tec499-20142/t01-core-musa/README.md

Projeto Core-MUSA
======
O projeto MUSA consiste no desenvolvimento da unidade de processamento do Processador MUSA.

Entendendo os Diretórios
-------------------------
  - doc    	: Contém todos os artefatos de documentação do sistema
  - rtl   	: Contém todos os módulos RTL sintetizáveis
  - fpga   	: Contém arquivos de projeto, constrais e módulos relativos ao FPGA
  - sim    	: Contém os módulos de teste, logs de simulação e banco de dados de formas de onda
