tec499-20142/t01-core-musa/rtl/README.md

Diretório de Arquivos RTL
==================================
Este diretório destina-se ao armazenamento dos módulos RTL sintetizáveis do projeto MUSA.

Organização de Subdiretórios
----------------------------
Sugere-se a organização dos subdiretórios da seguinte forma.

- sim/IF (arquivos do estágio IF);
- sim/ID (arquivos do estágio ID);
- sim/EX (arquivos do estágio EX);
- sim/MEM_WB (arquivos dos estágios MEM e WB);
