tec499-20142/t01-core-musa/doc/requirements/pt_br_requirements_specification.tex

%
% Portuguese-BR vertion
% 
\documentclass{article}
		
\usepackage{ipprocess}
% Use longtable if you want big tables to split over multiple pages.
\usepackage{longtable}
\usepackage[utf8]{inputenc} 
% Babel package is used to translate keywors to a specific language. 
% The option "brazil" defines portuguese-brazil as default language.
% Babel is also useful for hiphenation.
\usepackage[brazil]{babel}
		
\sloppy
		
\graphicspath{{./pictures/}} % Pictures dir
\makeindex
\begin{document}
		
\DocumentTitle{Especificação de Requisitos}
\Project{MUSA}
\Organization{Fazemos Qualquer Negócio Inc.}
\Version{Compilação 3.0}
\capa
			
%%%%%%%%%%%%%%%%%%%%%%%%%%%%%%%%%%%%%%%%%%%%%%%%%%
%% Revision History
%%%%%%%%%%%%%%%%%%%%%%%%%%%%%%%%%%%%%%%%%%%%%%%%%%

\section*{\center Histórico de Revisões}
	\vspace*{1cm}
	\begin{table}[ht]
		\centering
		\begin{tabular}[pos]{|m{2cm} | m{7.2cm} | m{3.8cm}|} \hline \cellcolor[gray]{0.9}

\textbf{Data} & \cellcolor[gray]{0.9}\textbf{Descrição} & \cellcolor[gray]{0.9} \textbf{Autor(es)}\\ \hline

\small 26/09/2014 & \small Inicialização do documento & \small patrickecomp \\ \hline      

\small 26/09/2014 & \small Inclusão dos requisitos [FR1] à [FR8] & \small patrickecomp \\ \hline 

\small 28/09/2014 & \small Inclusão dos requisitos [FR20] à [FR24] & \small santana22 e gabri14el \\ \hline

\small 28/09/2014 & \small Concepção da introdução e inclusão dos requisitos [FR10] e [FR11] & \small manuellemacedo \\ \hline 

\small 29/09/2014 & \small Inclusão dos requisitos [FR17] à [FR20], Inclusão dos requisitos [NFR3] à [NFR8] & \small patrickecomp, mirelarios e tarles-w7 \\ \hline    

\small 29/09/2014 & \small Inclusão dos requisitos [FR21] e [FR22] & \small ardersonqdv, lucas \\ \hline   

\small 29/09/2014 & \small Inclusão do requisito [FR7] & \small patrickecomp \\ \hline 

\small 30/09/2014 & \small Refinamento da introdução,  revisão preliminar do documento e revisão da [FR16] & \small santana22 \\ \hline

\small 30/09/2014 & \small Revisão do requisito [FR13] & \small santana22 e gabri14el \\ \hline

\small 30/09/2014 & \small Adição do requisito [NFR1] & \small santana22 \\ \hline

\small 30/09/2014 & \small Revisão dos requisitos [FR21] e [FR22] & \small lasilva\\ \hline

\small 30/09/2014 & \small Adição dos requisitos [FR23] à [FR26], adição dos requisitos [NFR2], [NFR9], [NFR10]  & \small manuellemacedo \\ \hline

\small 05/10/2014 & \small Revisão dos requisitos [FR12] à [FR16] & \small santana22 e gabri14el \\ \hline

\small 06/10/2014 & \small Adição dos requisitos [FR12], [FR14] [FR2], [FR4] & \small manuellemacedo \\ \hline %operações com imediato

\small 06/10/2014 & \small Adição dos requisitos [FR26] e revisão dos requisitos [NFR3], [NFR4], [NFR5] e [NFR8].  & \small patrickecomp e mirelarios \\ \hline

\small 06/10/2014 & \small Adição dos requisitos [FR17] à [FR19] & \small manuellemacedo \\ \hline % flags

\small 09/10/2014 & \small Revisão final do documento & \small manuellemacedo \\ \hline

		\end{tabular}
	\end{table}
\newpage

\section*{\center Histórico de Revisões}
\vspace*{1cm}
\begin{table}[ht]
	\centering
	\begin{tabular}[pos]{|m{2cm} | m{7.2cm} | m{3.8cm}|} \hline \cellcolor[gray]{0.9}
		
		\textbf{Data} & \cellcolor[gray]{0.9}\textbf{Descrição} & \cellcolor[gray]{0.9} \textbf{Autor(es)}\\ \hline
		
		\small 08/10/2014 & \small Adicionado a dependência do documento de requisitos da Processing Unit & \small Anderson e Lucas \\ \hline 
		
		\small 08/10/2014 & \small Mudança dos requisitos [FR29], [FR30] de NFR para FR, revisão dos requisitos [FR28], [NFR3], [NFR4] e [NFR5] & \small patrickecomp e mirelarios \\ \hline
		
		\small 08/10/2014 & \small Ajustes da introdução e das dependências. Remoção do NFR sobre Interfaceamento. & \small santana22 \\ \hline
		
		\small 15/10/2014 & \small Ajustes das instruções de desvios e da capa do documento. Ajustes das dependências. & \small santana22 e gabri14el \\ \hline
		
		\small 16/10/2014 & \small Ajustes nos requisitos funcionais de instruções lógicas e aritméticas & \small manuellemacedo \\ \hline
        
		\small 16/10/2014 & \small Ajustes nos requisitos funcionais de instruções de memória e ajuste nos requisitos não funcionais [NFR4] e [NFR2]. & \small patrickecomp \\ \hline
		
		\small 16/10/2014 & \small Ajustes dos requisitos [FR07], [FR16] e dos requisitos [FR26] e [FR27]. Alteração da introdução do documento e da seção 2: Requisitos funcionais. & \small lasilva \\ \hline 
		
  \end{tabular}
\end{table}
		
% TOC instantiation
\tableofcontents
\newpage
		
%%%%%%%%%%%%%%%%%%%%%%%%%%%%%%%%%%%%%%%%%%%%%%%%%%
%% Document main content
%%%%%%%%%%%%%%%%%%%%%%%%%%%%%%%%%%%%%%%%%%%%%%%%%%
\input{introducao}    
		
	\subsection{Visão Geral do Documento}
		\begin{itemize}
			\item \textbf{Requisitos funcionais -} lista de todos os requisitos funcionais.
			\item \textbf{Requisitos não funcionais -} lista de todos os requisitos não funcionais.
			\item \textbf{Dependências -} conjunto de dependências de IP-cores previstos.
		% 	\item \textbf{Notas -} apresenta a lista de notas apresentadas ao longo do documento.
		% 	\item \textbf{Referências -} lista de todos os textos referenciados nesse documento.
		\end{itemize}
		
	\subsection{Definições} 
		\begin{table}[H]
			\begin{center}
				\begin{tabular}[pos]{|m{2.5cm} | m{11.5cm}|} 
				\hline
				\cellcolor[gray]{0.9}\textbf{Termo} & \cellcolor[gray]{0.9}\textbf{Descrição} \\ \hline
				\flushright \centering {Requisito Funcional} & Requisitos de hardware que compõem os módulos, descrevendo as ações que o mesmo deve estar apto a executar. Estas informações são capturadas a partir do desenvolvimento dos casos de uso, que documentam as entradas, os processos e as saídas geradas.  \\ \hline
				\flushright \centering {Requisito Não \mbox{Funcional}} & Requisitos de hardware que compõem os módulos, representando as características que o mesmo deve ter, ou restrições que o mesmo deve operar. Estas características referem-se a técnicas, algoritmos, tecnologias e especificidades do Sistema como um todo.  \\ \hline
				\flushright \centering {Dependências} & Requisitos de reuso de IP-cores, descrevendo as funções que cada um deve exercer. \\ \hline
				\end{tabular}
			\end{center}
		\end{table}  
		
	% inicio da tabela de acronimos e abreviacoes do documento
	\subsection{Acrônimos e Abreviações}
	\begin{table}[H]
		\begin{center}
			\begin{tabular}[pos]{|m{2cm} | m{12cm}|} \hline
			\cellcolor[gray]{0.9}\textbf{Sigla} & \cellcolor[gray]{0.9}\textbf{Descrição} \\ \hline
		          FR      & Requisito Funcional  \\ \hline
		          NFR     & Requisito Não Funcional  \\ \hline
		          D       & Dependência  \\ \hline
				  PC      & Program Counter \\ \hline 
			\end{tabular}
		\end{center}
	\end{table}  
	% fim  
		
	% inicio da descriao de prioridades de requisitos
	\subsection{Prioridades dos Requisitos}

	\begin{table}[H]
		\begin{center}
			\begin{tabular}[pos]{|m{2cm} | m{12cm}|} \hline
			\cellcolor[gray]{0.9}\textbf{Prioridade} & \cellcolor[gray]{0.9}\textbf{Característica} \\ \hline
			Importante      & Requisito sem o qual o sistema funciona, porém não como deveria.  \\ \hline
			Essencial       & Requisito que deve ser implementado para que o sistema funcione.  \\ \hline
			Desejável       & Requisito que não compromete o funcionamento do sistema.  \\ \hline
			\end{tabular}
		\end{center}
	\end{table}  
	% fim
		
\section{Requisitos Funcionais}
		Nesta seção são descritos os requisitos das instruções que devem ser realizadas pelo IP-core MUSA. 
		Nas subseções 2.1 e 2.2 são descritos os requisitos funcionais das operações lógicas e aritméticas.
		Nas subseções 2.3, 2.4 e 2.5 são apresentados os requisitos para as instruções de desvio, memória e 
		controle respectivamente. 
	\input{requisitosaritmetica}
	\input{requisitoslogicos}
	\input{requisitosdesvio}
	\input{requisitosmemoria}
	\input{requisitoscontrole}
			  
\section{Requisitos não Funcionais}
Esta seção apresenta a lista de Requisitos não Funcionais do projeto.
		  
	\input{naofuncional}
		  
\section{Dependências}
	
	\input{dependencias}  
	
% Optional bibliography section
% To use bibliograpy, first provide the ipprocess.bib file on the root folder.
% \bibliographystyle{ieeetr}
% \bibliography{ipprocess}
		  
\end{document}
