tec499-20142/t01-core-musa/doc/requirements/introducao.tex

\section{Introdução}

 A \textbf{Fazemos Qualquer Negócio Inc.} foi contratada para o desenvolvimento do \textit{IP-Core} \textbf{MUSA}, que é um micro processador de
 propósito geral que será utilizado em escolas de países africanos com o intuito de impulsionar o desenvolvimento deste continente. As seções
 subsequentes apresentam os requisitos funcionais e não funcionais como parte da fase de \textbf{Concepção} do IP-process.
 Os requisitos listados foram definidos a partir das necessidades do cliente para produção do \textit{MUSA}.
