tec499-20142/t01-core-musa/doc/requirements/requisitosaritmetica.tex

\subsection{Conjunto de Instruções Aritméticas} 
  
    \begin{functional}
      \requirement{Instrução ADD}
      {O módulo deve ser capaz de realizar a operação de soma de dois valores de 32 bits.}
      {Essencial}
      
       \requirement{Instrução ADDI}
      {O módulo deve ser capaz de realizar a operação de soma de dois valores de 32 bits, sendo um destes valor imediato.}
      {Essencial}

      \requirement{Instrução SUB}
      {O módulo deve ser capaz de realizar a operação de subtração de dois valores de 32 bits.}
      {Essencial}
      
      \requirement{Instrução SUBI}
      {O módulo deve ser capaz de realizar a operação de subtração de dois valores de 32 bits, sendo um destes valor imediato.}
      {Essencial}

      \requirement{Instrução MUL}
      {O módulo deve ser capaz de realizar a operação de multiplicação de dois valores de 32 bits. }
      {Essencial}

      \requirement{Instrução DIV}
      {O módulo deve ser capaz de realizar a operação de divisão de dois valores de 32 bits.}
      {Essencial} 

      \requirement{Tamanho da palavra de saída}
      {O componente deve apresentar uma saída única de 32 bits para todas as operações aritméticas.}
      {Essencial}       

      \requirement{Detecção de overflow aritmético}
      {O módulo deve ser capaz de detectar \textit{overflow} aritmético.}
      {Essencial}
      
      \requirement{Detecção de underflow aritmético}
      {O módulo deve ser capaz de detectar \textit{underflow} aritmético.}
      {Essencial}
      
%      \requirement{Detecção de zero}
%      {O módulo deve ser capaz de detectar no resultado da operação o valor zero e habilitar uma \textit{flag}.}
%      {Importante}
      
    \end{functional}
