tec499-20142/t01-core-musa/doc/requirements/requisitosdesvio.tex

\subsection{Conjunto de Instruções de Desvio}
	    
	  \begin{functional}
		\requirement{Instrução JR}
		{O módulo deve ser capaz de realizar desvios para endereços armazenados no registrador de destino.}
		{Essencial} 
		 
		 \requirement{Instrução JPC}
		 {O módulo deve ser capaz de realizar desvios para endereços relativos ao PC.}
		 {Essencial}
		 
		 \requirement{Instrução BRFL}
		 {O módulo deve ser capaz de realizar desvios condicionais com base no registrador de \textit{flags}.}
		 {Essencial}
		 
		 \requirement{Instrução CALL}
		 {O módulo deve ser capaz de desviar a execução para uma sub-rotina.}
		 {Essencial}
		 
		 \requirement{Instrução RET}
		 {O módulo deve ser capaz de retornar de uma sub-rotina.}
		 {Essencial}
         
	  \end{functional}
