tec499-20142/t01-core-musa/doc/requirements/requisitoslogicos.tex

\subsection{Conjunto de Instruções Lógicas} 
  
    \begin{functional}
    
      \requirement{Instrução AND}
      {O módulo deve ser capaz de realizar a operação AND lógico de dois operandos de 32 bits.}
      {Essencial}
      
     \requirement{Instrução ANDI}
      {O módulo deve ser capaz de realizar a operação AND lógico de dois operandos de 32 bits, sendo um destes valor imediato.}
      {Essencial}

      \requirement{Instrução OR}
      {O módulo deve ser capaz de realizar a operação OR lógico de dois operandos de 32 bits.}
      {Essencial}  
      
      \requirement{Instrução ORI}
      {O módulo deve ser capaz de realizar a operação OR lógico de dois operandos de 32 bits, sendo um destes valor imediato.}
      {Essencial} 
      
      \requirement{Instrução NOT}
      {O módulo deve ser capaz de realizar a operação NOT lógico de um operando de 32 bits.}
      {Essencial}   
      
      \requirement{Instrução CMP}
      {O módulo deve ser capaz de comparar dois operandos de 32 bits e ativa \textit{flags}.}
      {Essencial}
      
%      \requirement{Ativação do flag \textit{above}}
%      {O módulo deve ser capaz de ativar o flag \textit{above} após uma comparação entre duas entradas.}
%      {Importante}
      
%      \requirement{Ativação do flag \textit{equals}}
%      {O módulo deve ser capaz de ativar o flag \textit{equals} após uma comparação entre duas entradas.}
%      {Importante}
      
%      \requirement{Ativação do flag \textit{error}}
%      {O módulo deve ser capaz de ativar o flag \textit{error} após um erro ser detectado.}
%      {Importante}
      
    \end{functional}
