tec499-20142/t01-core-musa/doc/requirements/requisitosmemoria.tex

\subsection{Conjunto de Instruções de acesso à Memória}

	  \begin{functional}
		\requirement{Operação LW}
		{O módulo deve ser capaz de realizar leitura de dados na memória de dados.}
		{Essencial}
		
		\requirement{Operação SW}
		{O módulo deve ser capaz de armazenar dados na memória de dados.}
		{Essencial}
		
		\requirement{Leitura da memória de instruções}
		{O módulo deve ser capaz de ler instruções na memória de instruções.}
		{Essencial}
                
        \requirement{Modo de endereçamento de dados}
        {O módulo deve possuir três modos de endereçamento: imediato, por registrador e base-deslocamento.}
        {Essencial}

		\requirement{Padrão de conversão de tamanho de palavra}
		{O módulo deve converter dados de 16 bits para 32 bits utilizando o padrão zero-extend ou o padrão sign-extend.}
		{Essencial}
		 
	 \end{functional}
