tec499-20142/t01-core-musa/doc/requirements/pt_br_requirements_specification2.tex

%
% Portuguese-BR vertion
% 
\documentclass{article}

\usepackage{ipprocess}
% Use longtable if you want big tables to split over multiple pages.
% \usepackage{longtable}
\usepackage[utf8]{inputenc} 
% Babel package is used to translate keywors to a specific language. 
% The option "brazil" defines portuguese-brazil as default language.
% Babel is also useful for hiphenation.
\usepackage[brazil]{babel}

\sloppy

\graphicspath{{./pictures/}} % Pictures dir
\makeindex
\begin{document}

\DocumentTitle{Especificação de Requisitos}
\Project{Processador de Propósito Geral Simples}
\Organization{Universidade Estadual de Feira de Santana}
\Version{Compilação 2.0}
\capa

\newpage
	
	%%%%%%%%%%%%%%%%%%%%%%%%%%%%%%%%%%%%%%%%%%%%%%%%%%
	%% Revision History
	%%%%%%%%%%%%%%%%%%%%%%%%%%%%%%%%%%%%%%%%%%%%%%%%%%
	\section*{\center Histórico de Revisões}
	  \vspace*{1cm}
	  \begin{table}[ht]
	    \centering
	    \begin{tabular}[pos]{|m{2cm} | m{7.2cm} | m{3.8cm}|} 
	      \hline
	      \cellcolor[gray]{0.9}
	      \textbf{Data} & \cellcolor[gray]{0.9}\textbf{Descrição} & \cellcolor[gray]{0.9}\textbf{Autor(es)}\\ \hline
	      \hline
	      \small 26/09/2014 & \small Inicialização do documento & \small patrickecomp \\ \hline      
	      \small 26/09/2014 & \small Inclusão dos requisitos [FR1] à [FR8] & \small patrickecomp \\ \hline 
	      \small 28/09/2014 & \small Inclusão dos requisitos [FR12] à [FR16] & \small santana22 e gabri14el \\ \hline
	      \small 28/09/2014 & \small Concepção da introdução e inclusão dos requisitos [FR10] e [FR11] & \small manuellemacedo \\ \hline 
	      \small 29/09/2014 & \small Inclusão dos requisitos [FR17] à [FR20], Inclusão dos requisitos [NFR3] à [NFR8] & \small patrickecomp, mirelarios e tarles-w7 \\ \hline    
	      \small 29/09/2014 & \small Inclusão dos requisitos [FR21] e [FR22] & \small ardersonqdv, lucas \\ \hline   
	      \small 29/09/2014 & \small Inclusão do requisito [FR7] & \small patrickecomp \\ \hline 
	      \small 30/09/2014 & \small Refinamento da introdução,  revisão preliminar do documento e revisão da [FR16] & \small santana22 \\ \hline
	      \small 30/09/2014 & \small Revisão do requisito [FR13] & \small santana22 e gabri14el \\ \hline
	      \small 30/09/2014 & \small Adição do requisito [NFR1] & \small santana22 \\ \hline
	      \small 30/09/2014 & \small Revisão dos requisitos [FR21] e [FR22] & \small lasilva\\ \hline
	      \small 30/09/2014 & \small Adição dos requisitos [FR23] à [FR26], adição dos requisitos [NFR2], [NFR9], [NFR10]  & \small manuellemacedo \\ \hline
	    \end{tabular}
	  \end{table}
	
	\newpage
	
	% TOC instantiation
	\tableofcontents
	\newpage
	
	%%%%%%%%%%%%%%%%%%%%%%%%%%%%%%%%%%%%%%%%%%%%%%%%%%
	%% Document main content
	%%%%%%%%%%%%%%%%%%%%%%%%%%%%%%%%%%%%%%%%%%%%%%%%%%
	\input{introducao}    
	
	\subsection{Visão Geral do Documento}
	  \begin{itemize}
	   \item \textbf{Requisitos funcionais -} lista de todos os requisitos funcionais.
	   \item \textbf{Requisitos não funcionais -} lista de todos os requisitos não funcionais.
	%   \item \textbf{Dependências -} conjunto de dependências de IP-cores previstos.
	   % \item \textbf{Notas -} apresenta a lista de notas apresentadas ao longo do documento.
	   % \item \textbf{Referências -} lista de todos os textos referenciados nesse documento.
	  \end{itemize}
	
	  \subsection{Definições}
	  
	  \FloatBarrier
	  \begin{table}[H]
	    \begin{center}
	      \begin{tabular}[pos]{|m{2.5cm} | m{11.5cm}|} 
	        \hline
	        \cellcolor[gray]{0.9}\textbf{Termo} & \cellcolor[gray]{0.9}\textbf{Descrição} \\ \hline
	        \flushright \centering {Requisito Funcional} & Requisitos de hardware que compõem os módulos, descrevendo as ações que o 
	                                    mesmo deve estar apto a executar. Estas informações são capturadas a partir 
	                                    do desenvolvimento dos casos de uso, que documentam as entradas, os processos 
	                                    e as saídas geradas.  \\ \hline
	        \flushright \centering {Requisito Não \mbox{Funcional}} & Requisitos de hardware que compõem os módulos, representando as características 
	                                    que o mesmo deve ter, ou restrições que o mesmo deve operar. Estas características
	                                    referem-se a técnicas, algoritmos, tecnologias e especificidades do Sistema como um todo.  \\ \hline
	%        \flushright \centering {Dependências}              & Requisitos de reuso de IP-cores, descrevendo as funções que cada um deve exercer. \\ \hline
	      \end{tabular}
	    \end{center}
	  \end{table}  
	
	  % inicio da tabela de acronimos e abreviacoes do documento
	  \subsection{Acrônimos e Abreviações}
	    \FloatBarrier
	    \begin{table}[H]
	      \begin{center}
	        \begin{tabular}[pos]{|m{2cm} | m{12cm}|} 
	          \hline
	          \cellcolor[gray]{0.9}\textbf{Sigla} & \cellcolor[gray]{0.9}\textbf{Descrição} \\ \hline
	          FR      & Requisito Funcional  \\ \hline
	          NFR     & Requisito Não Funcional  \\ \hline
	%          D       & Dependência  \\ \hline
			  PC      & Program Counter \\ \hline 
	        \end{tabular}
	      \end{center}
	    \end{table}  
	  % fim  
	
	  % inicio da descriao de prioridades de requisitos
	  \subsection{Prioridades dos Requisitos}
	    \FloatBarrier
	    \begin{table}[H]
	      \begin{center}
	        \begin{tabular}[pos]{|m{2cm} | m{12cm}|} 
	          \hline
	          \cellcolor[gray]{0.9}\textbf{Prioridade} & \cellcolor[gray]{0.9}\textbf{Característica} \\ \hline
	          Importante      & Requisito sem o qual o sistema funciona, porém não como deveria.  \\ \hline
	          Essencial       & Requisito que deve ser implementado para que o sistema funcione.  \\ \hline
	          Desejável       & Requisito que não compromete o funcionamento do sistema.  \\ \hline
	        \end{tabular}
	      \end{center}
	    \end{table}  
	  % fim
	
	\section{Requisitos Funcionais}
	
	\input{requisitosaritmetica}
	
	\input{requisitoslogicos}
	    
	\input{requisitosdesvio}
	      
	\input{requisitosmemoria}
	 
	\input{requisitoscontrole}
		  
	 \section{Requisitos não Funcionais}
	  Esta seção apresenta a lista de Requisitos não Funcionais do projeto.
	  
	  \begin{nonfunctional}
	  	
	  \requirement{Interfaceamento}
	  {Este módulo deve ser capaz de interfacear com um mecanismo de saída.}
	  {Desejável}
	  
	  \requirement{Tamanho da palavra de instrução}
	  {O tamanho da palavra de intrução será de 16 bits.}
	  {Importante}
	  
	   \requirement{Modo de Armazenamento}
        {O tratamento e o armazenamento na memória de dados será feito no formato big-endian.}
        {Importante}
        
        \requirement{Modo de endereçamento da memória de dados e instruções}
        {O módulo deve possuir dois modos de endereçamento: Imediato e Direto.}
        {Importante}
        
       \requirement{Tipo de memória de dados}
        {O módulo deve utilizar memória do tipo SSRAM.}
        {Imnportante}
        
       \requirement{Tamanho da memória de dados}
        {A memória de dados deve ser de 512 Kbyte.}
        {Essencial}
        
       \requirement{Tamanho da memória de instruções}
        {A memória de dados deve ser de 512 Kbyte.}
        {Essencial}
        
       \requirement{Tamanho do banco de registradores}
        {O banco de registradores possui 8 registradores cada um
com 8 bits.}
        {Essencial}
	  
		\requirement{Formato dos Números}
		{Na representação dos números inteiros para a soma e subtração será adotado números com sinal e o complemento a 2 para representação de valores negativos}
		{Importante}
		
		\requirement{Arquitetura multi-ciclo}
		{As instruções serão executadas em alguns ciclos de clock.}
		{Essencial}		
			  
	  \end{nonfunctional}
	  
	\end{document}
