tec499-20142/t01-core-musa/doc/usecases/pt_br_use_cases.tex

 %
% Portuguese-BR vertion
% 
\documentclass{article}

\usepackage{ipprocess}
% Use longtable if you want big tables to split over multiple pages.
% \usepackage{longtable}
\usepackage[utf8]{inputenc} 
\usepackage[brazil]{babel} % Uncomment for portuguese
\usepackage{pdflscape}
\usepackage{tikz}
\usepackage{tikz-uml}

\sloppy

\graphicspath{{./pictures/}} % Pictures dir
\makeindex
\begin{document}

\DocumentTitle{Documento de Casos de Uso}
\Project{MUSA}
\Organization{Fazemos Qualquer Negócio Inc.}
\Version{Compilação 2.0}

\capa
\newpage

%%%%%%%%%%%%%%%%%%%%%%%%%%%%%%%%%%%%%%%%%%%%%%%%%%
%% Revision History
%%%%%%%%%%%%%%%%%%%%%%%%%%%%%%%%%%%%%%%%%%%%%%%%%%
\section*{\center Histórico de Revisões}
  \vspace*{1cm}
  \begin{table}[ht]
    \centering
    \begin{tabular}[pos]{|m{2cm} | m{7.2cm} | m{3.8cm}|} 
      \hline
      \cellcolor[gray]{0.9}
      \textbf{Data} & \cellcolor[gray]{0.9}\textbf{Descrição} & \cellcolor[gray]{0.9}\textbf{Autor(s)}\\ \hline
      
      \small 03/10/2014 & \small Document conception & \small manuellemacedo \\ \hline      
	
      \small 07/10/2014 & \small Adição do caso de uso da unidade lógica e aritmética & \small manuellemacedo \\ \hline
      \small 09/10/2014 & \small Retirado alguns atores do documento. Modificado os Casos de uso da Unidade de Controle e da UL. Adicionado algumas definições de siglas do Diagrama de Caso de Uso. & \small Lucas e Anderson \\ \hline 
      \small 09/10/2014 & \small Formatação e ajuste do documento & \small santana22 \\ \hline
      \small 09/10/2014 & \small Adição do caso de uso [UC 005] & \small tarleswalker \\ \hline
      \small 09/10/2014 & \small Adição dos casos de usos [UC 002] e [UC 003] & \small manuellemacedo \\ \hline
       \small 09/10/2014 & \small Adição do caso de uso [UC 004] & \small weverson \\ \hline
       \small 16/10/2014 & \small Refatoração da capa,  & \small manuellemacedo \\ \hline
       \small 24/10/2014 & \small Edição do caso de uso unidade de controle  & \small mirelarios e patrickecomp \\ \hline
       \small 24/10/2014 & \small Ajustes de sintaxe  & \small manuellemacedo \\ \hline
       \small 29/10/2014 & \small Edição do caso de uso Extensor de Bits  & \small mirelarios e patrickecomp \\ \hline
       \small 14/12/2014 & \small Refatoração do documento & \small santana22 \\ \hline
		\small 18/12/2014 & \small Refatoração do 	documento & \small santana22 e tarleswalker\\ \hline       
    \end{tabular}
  \end{table}

\newpage

% TOC instantiation
\tableofcontents
\newpage

%%%%%%%%%%%%%%%%%%%%%%%%%%%%%%%%%%%%%%%%%%%%%%%%%%
%% Document main content
%%%%%%%%%%%%%%%%%%%%%%%%%%%%%%%%%%%%%%%%%%%%%%%%%%
\input{introducao}

\input{atores}

\section{Casos de Usos}

	\input{instructionadd-sub-mult-div}
	\input{instruction-logicas}
	\input{instruction-imediatas}
	\input{instruction-memoria}
	\input{instruction-jump}

	%\input{unidadecontrole}

	%\input{ula}
	
	%\input{memoria}
	
	%\input{banco_registradores}
	
	%\input{extensor}

% Optional bibliography section
% To use bibliograpy, first provide the ipprocess.bib file on the root folder.
% \bibliographystyle{ieeetr}
% \bibliography{ipprocess}

\end{document}
