tec499-20142/t01-core-musa/doc/architecture/class_diagrams/Diagrama_de_classe_Stage_3_Esbo_o_.png

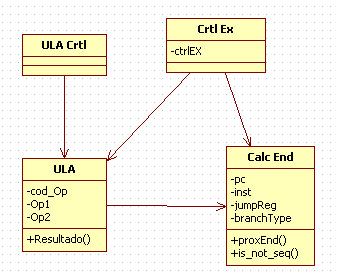
doc/architecture/class_diagrams/Diagrama_de_classe_Stage_3_Esbo_o_.png
