tec499-20142/t01-core-musa/doc/architecture/class_diagrams/estagioex.png

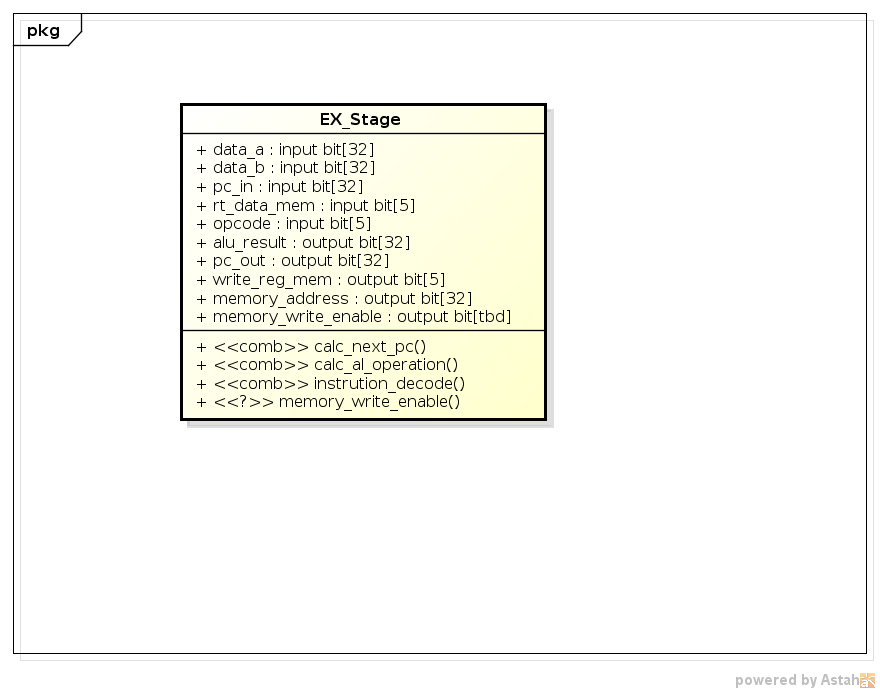
doc/architecture/class_diagrams/estagioex.png
