tec499-20142/t01-core-musa/doc/architecture/class_diagrams/por_est_gio.jpg

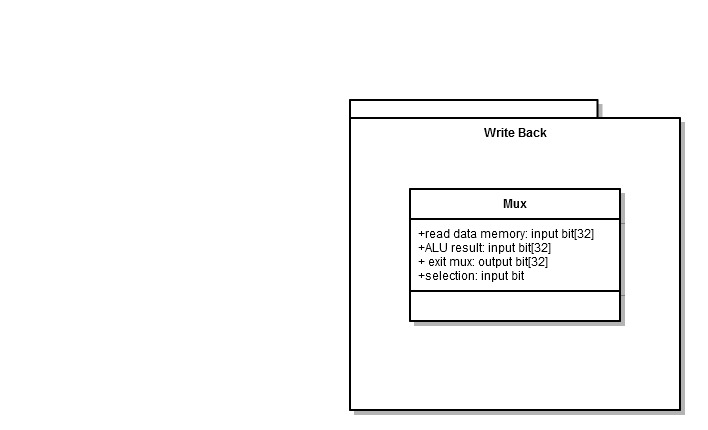
doc/architecture/class_diagrams/por_est_gio.jpg
