tec499-20142/t01-core-musa/doc/architecture/datapath/datapath_final.jpg

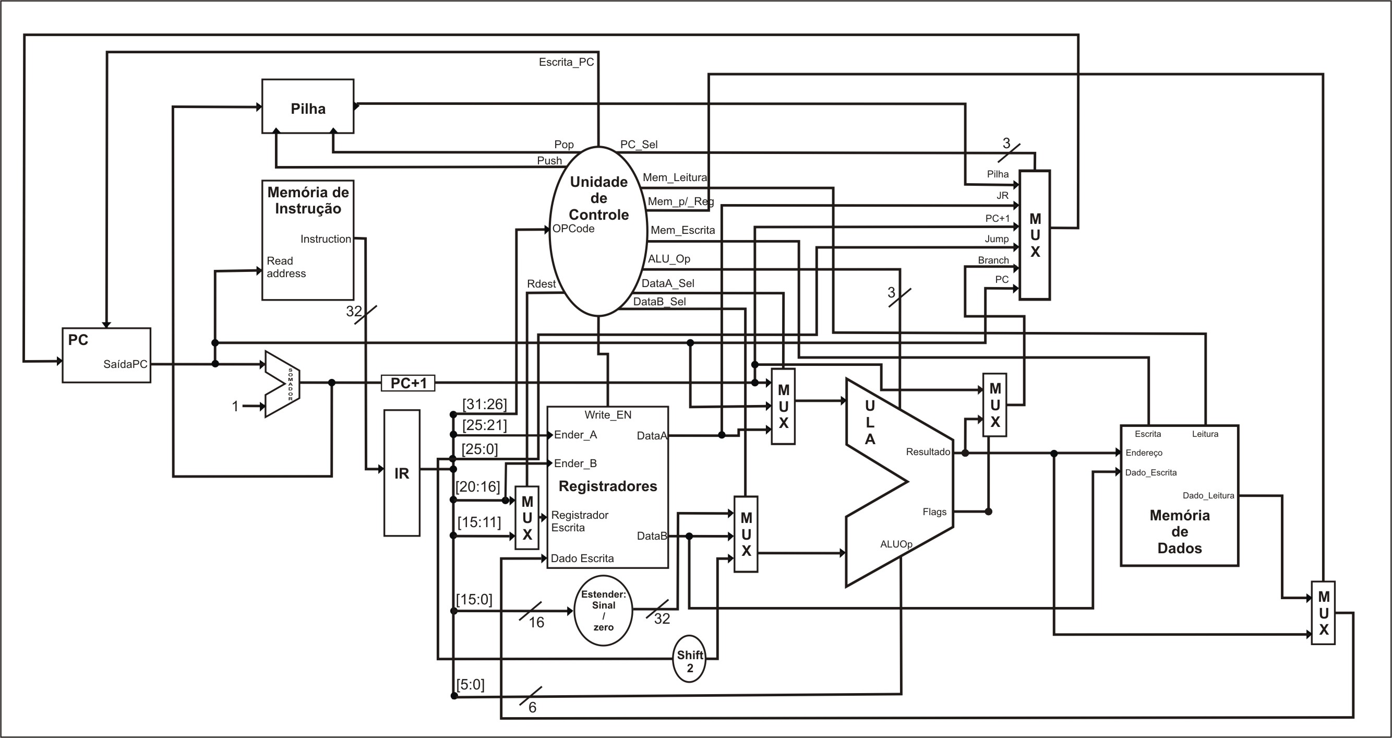
doc/architecture/datapath/datapath_final.jpg
