tec499-20142/t01-core-musa/doc/architecture/datapath/stage3.png

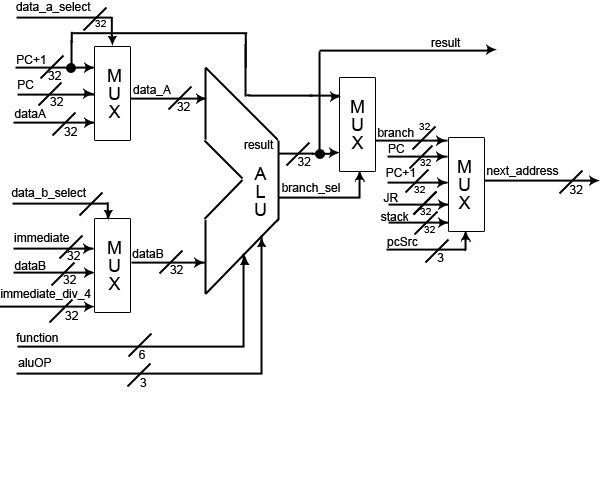
doc/architecture/datapath/stage3.png
