tec499-20142/t01-core-musa/doc/architecture/componentes.tex

\section{Descrição dos Componentes}
  A unidade de processamento a ser desenvolvida é composta a partir dos seguintes componentes:

  \begin{itemize}
    \item \textbf{Instruction Fetch --} Módulo responsavel pela busca da instrução na memória de instrução.
    \item \textbf{Instruction Decode e Register Read --} Módulo responsável pela decodificação das instruções e leitura do banco de registradores.
    \item \textbf{Execute Operation or Calculate Address --} Módulo responsável pela execução as operações de caractér lógico/aritmético ou cálculos endereços.
     \item \textbf{Memory Access e Write Back --} Módulo responsável pelo acesso a memória de dados e escrita no banco de registradores.
  \end{itemize}
