tec499-20142/t01-core-musa/(list of files, cad)

Other CAD files:
sim/ver/temp_ver/shift_two/verilog.psm
sim/ver/temp_ver/sign_extend/verilog.psm
sim/ver/temp_ver/sp_ram_with_init/verilog.psm
sim/ver/temp_ver/stage_@four_@five/verilog.psm
sim/ver/temp_ver/unit_control/verilog.psm
