tec499-20142/t01-core-musa/doc/usecases/usecases/instruction-jump.tikz.tex

\flushleft
  \begin{tikzpicture} 
    \begin{umlsystem}[x=0, fill=red!10]{Instruções de Desvio} 
      \umlusecase[x=-4,y=-3,name=buscar]{Buscar} 
      \umlusecase[x=0,y=-3, fill=green!20,width=1cm, name=enviar]{Enviar} 

	  \umlusecase[x=0,y=-5,name=decodificar]{Decodificar} 
      \umlusecase[x=-4,y=-5, fill=green!20,width=1cm, name=emitir]{Emitir}

	  \umlusecase[x=-4,y=-8,name=operar]{Operar/Calcular} 
      \umlusecase[x=0,y=-9, fill=green!20,width=1cm, name=mod_end]{Modificar Endereço}

      \umlactor[x=-8,y=-3]{IF} 
      \umlactor[x=4,y=-4]{ID}   
      \umlactor[x=-8,y=-6]{EX}

      \umlassoc{IF}{buscar}
      \umlassoc{enviar}{ID}
      \umlassoc{buscar}{enviar}
      
      \umlassoc{ID}{decodificar}
      \umlassoc{emitir}{EX}
      \umlassoc{decodificar}{emitir}

      \umlassoc{EX}{operar}
       \umlassoc{operar}{mod_end}
       \umlassoc{mod_end}{IF}
    \end{umlsystem} 
  \end{tikzpicture}
