tec499-20142/t01-core-musa/doc/architecture/step2.tex

\section{Decodificação da Instrução}
	\subsection{Diagrama de Classe}
  \begin{figure}[htpb!]
    \input{./classes/step2.tikz}
  \end{figure}
		
		\subsection{Definições de entrada e saída}
		
	\begin{center}
		\begin{longtable}[pos]{| l | c | c | m{7cm} |} \hline
			\multicolumn{1}{|c|}{\cellcolor[gray]{0.9}\textbf{Nome}} & 
			\multicolumn{1}{c|}{\cellcolor[gray]{0.9}\textbf{Tamanho}} & 
			\multicolumn{1}{c|}{\cellcolor[gray]{0.9}\textbf{Direção}} &
			\multicolumn{1}{c|}{\cellcolor[gray]{0.9}\textbf{Descrição}} \\ \hline
			\endhead
			\hline
			\endlastfoot
			
			clock & 1 & entrada & Clock do sistema \\ \hline
			reset & 1 & entrada & Sinal de reinício do estágio\\ \hline
			instruction & 32 & entrada & Instrução a ser executada. \\ \hline
			regDst & 1 & saída & Sinal que seleciona o endereço do registrador a ser escrito no banco registradores \\ \hline
			memRead & 1 & saída & Sinal de controle para realizar leitura da
			memória.
			\\ \hline
			memToReg & 1 & saída & Sinal de controle que define se o dado
			deve vir da ULA ou da memória
			\\ \hline
			aluOp & 3 & saída & Sinal que informa qual o tipo da operação que será realizada \\ \hline
			memWrite & 1 & saída & Sinal de controle para realizar escrita na
			memória. \\ \hline
			regWrite & 1 & saída & Sinal de controle para realizar escrita no
			registrador. \\ \hline
			data\_a\_select & 2 & saída &  Sinal para selecionar o conteúdo do primeiro operando \\ \hline
			data\_b\_select & 2 & saída & Sinal para selecionar o conteúdo do segundo operando operando \\ \hline
			pcSrc & 3 & saída & Sinal para selecionar o endereço da próxima instrução a ser executada \\ \hline
			pcWrite & 1 & saída & Sinal que habilita a modificação do valor de PC \\ \hline
			pop & 1 & saída & Sinal que habilita a leitura da Pilha de Instruções \\ \hline
			push & 1 & saída & Sinal que habilita a escrita na Pilha de Instruções \\ \hline
			writeData & 32 & entrada & Dado que será escrito no banco de registradores. \\ \hline
			writeRegister & 5 & entrada & Endereço do registrador a ser escrito no banco registradores \\ \hline
			function & 6 & saída & Variante especifica da operação \\\hline
			inst\_out & 32 & saída & Constante numérica  \\ \hline
			imdt\_div\_4 & 32 & saída & Contante numérica \\\hline
			opcode & 6 & entrada & Código da instrução a ser executada \\ \hline
			readRegister1 & 5 & entrada & Endereço do primeiro registrador \\ \hline
			readRegister2 & 5 & entrada & Endereço do segundo registrador\\ \hline 
			readData1 & 32 & saída & Conteúdo do primeiro registrador \\ \hline 
			readData2 & 32 & saída & Conteúdo do segundo registrador \\ \hline
		\end{longtable}
	\end{center}
    
    		\subsection{Tabela de microinstruções}

	\begin{center}
		\begin{longtable}[pos]{| c | c |} \hline
			\multicolumn{1}{|c|}{\cellcolor[gray]{0.9}\textbf{Código}} & 
			\multicolumn{1}{c|}{\cellcolor[gray]{0.9}\textbf{Instrução}} \\ \hline 
			\endhead
			\hline
			\endlastfoot
			
	    	1 & Lógicas, Aritméticas, MUL e DIV\\ \hline
            2 & ADDI \\ \hline
            3 & ANDI \\ \hline
            4 & SUBI \\ \hline
            5 & ORI \\ \hline
            6 & SW \\ \hline
            7 & LW \\ \hline
            8 & JR\\ \hline
            9 & JPC\\ \hline
            10 & BRFL\\ \hline
            11 & CALL\\ \hline
            12 & RET\\ \hline
            13 & HALT\\ \hline
            14 & NOP\\ \hline
            15 & CMP\\ \hline
		\end{longtable}
	\end{center}

	\begin{center}
		\begin{longtable}[pos]{| c | c | c | c | c | c | c | c | c | c | c | c | c | c | c | c | c |} \hline
			\multicolumn{1}{|c|}{\cellcolor[gray]{0.9}\textbf{\small Código}} & 
			\multicolumn{1}{c|}{\cellcolor[gray]{0.9}\textbf{1}} & 
			\multicolumn{1}{c|}{\cellcolor[gray]{0.9}\textbf{2}} &
			\multicolumn{1}{c|}{\cellcolor[gray]{0.9}\textbf{3}} &
            \multicolumn{1}{c|}{\cellcolor[gray]{0.9}\textbf{4}} &
            \multicolumn{1}{c|}{\cellcolor[gray]{0.9}\textbf{5}} &
            \multicolumn{1}{c|}{\cellcolor[gray]{0.9}\textbf{6}} &
            \multicolumn{1}{c|}{\cellcolor[gray]{0.9}\textbf{7}} &
            \multicolumn{1}{c|}{\cellcolor[gray]{0.9}\textbf{8}} &
            \multicolumn{1}{c|}{\cellcolor[gray]{0.9}\textbf{9}} &
            \multicolumn{1}{c|}{\cellcolor[gray]{0.9}\textbf{10}} &
			\multicolumn{1}{c|}{\cellcolor[gray]{0.9}\textbf{11}} &
			\multicolumn{1}{c|}{\cellcolor[gray]{0.9}\textbf{12}} &
            \multicolumn{1}{c|}{\cellcolor[gray]{0.9}\textbf{13}} &
            \multicolumn{1}{c|}{\cellcolor[gray]{0.9}\textbf{14}} &
            \multicolumn{1}{c|}{\cellcolor[gray]{0.9}\textbf{15}} \\ \hline
			\endhead
			\hline
			\endlastfoot
			
			\small regDst 			& 1   & 0   & 0   & 0   & 0   & 0   & 0   & 0   & 0   & 0   & 0   & 0   & 0  & 0 & 0 & 0\\ \hline
            \small memRead 			& 0   & 0   & 0   & 0   & 0   & 0   & 1   & 0   & 0   & 0   & 0   & 0   & 0  & 0 & 0 & 0\\ \hline
            \small memToReg 		& 0   & 0   & 0   & 0   & 0   & 0   & 1   & 0   & 0   & 0   & 0   & 0   & 0  & 0 & 0 & 0\\ \hline
            
            \small aluOp 			& \small 010 & \small 000 & \small 011 & \small 001 & \small 100 & \small 000 & \small 000 & \small 000 & \small 000 & \small 101 & \small 000 & \small 000 & \small 000 & \small 010 & \small 110 & \small 110\\ \hline
            
            \small memWrite 		& 0   & 0   & 0   & 0   & 0   & 1   & 0   & 0   & 0   & 0   & 0   & 0   & 0  & 0 & 0& 0\\ \hline
            \small regWrite 		& 1   & 1   & 1   & 1   & 1   & 0   & 1   & 0   & 0   & 0   & 0   & 0   & 0  & 0 & 0 & 0\\ \hline
            \small data\_a\_select	& 10  & 10  & 10  & 10  & 10  & 10  & 10  & 00  & 00  & 10  & 00  & 00  & 00 & 00 & 10 & 10\\ \hline
            \small data\_b\_select 	& 01  & 00  & 00  & 00  & 00  & 00  & 00  & 00  & 10  & 00  & 00  & 00  & 00 & 00 & 01 & 01\\ \hline
            
            \small pcSrc 			& \small 010 & \small 010   & \small 010 & \small 010 & \small 010 & \small 010 & \small 010 & \small 001 & \small 011 & \small 001 & \small 001 & \small 000 & \small 100 & \small 010 & \small 001& \small 001\\ \hline
            
            \small pop 				& 0   & 0   & 0   & 0   & 0   & 0   & 0   & 0   & 0   & 0   & 0   & 1   & 0  & 0 & 0 & 0\\ \hline
            \small push 			& 0   & 0   & 0   & 0   & 0   & 0   & 0   & 0   & 0   & 0   & 1   & 0   & 0  & 0 & 0 & 0\\ \hline

		\end{longtable}
	\end{center}
   
   \newpage
	
	\subsection{Datapath Interno}
	
	\begin{figure}[h!]
		\begin{center}
		
		\end{center}
	\end{figure}
