tec499-20142/t01-core-musa/doc/usecases/instruction-logicas.tex

\usecase{Instrução AND}

Este caso de uso especifica a ação da instrução AND. O objetivo é realizar uma a operação lógica AND entre dois valores.
 
\subsubsection*{Atores}
\textbf{IF, ID, EX, MEM/WB}

\preconditions 
\begin{itemize}
 \item O módulo \textbf{IF} precisa buscar uma instrução AND.
\end{itemize}

\postconditions
\begin{itemize}	
  \item Permitir execução da próxima instrução.
\end{itemize}

\subsubsection*{Fluxo Básico}
\begin{itemize}
\item O módulo \textbf{IF} busca a instrução AND a ser executada.
\item O módulo \textbf{ID} decodifica o tipo da instrução, emite sinais de controle para os demais módulos e disponibiliza os valores para o módulo \textbf{EX}.
\item O módulo \textbf{EX} realiza a operação lógica determinada dos valores e atualiza para a próxima instrução.
\item O módulo \textbf{MEM/WB} armazena o resultado da operação no módulo \textbf{ID}.
\end{itemize}

\usecase{Instrução OR}

Este caso de uso especifica a ação da instrução OR. O objetivo é realizar a operação lógica OR entre dois valores.
 
\subsubsection*{Atores}
\textbf{IF, ID, EX, MEM/WB}

\preconditions 
\begin{itemize}
 \item O módulo \textbf{IF} precisa buscar uma instrução OR.
\end{itemize}

\postconditions
\begin{itemize}	
  \item Permitir execução da próxima instrução.
\end{itemize}

\subsubsection*{Fluxo Básico}
\begin{itemize}
\item O módulo \textbf{IF} busca a instrução OR a ser executada.
\item O módulo \textbf{ID} decodifica o tipo da instrução, emite sinais de controle para os demais módulos e disponibiliza os valores para o módulo \textbf{EX}.
\item O módulo \textbf{EX} realiza a operação lógica determinada dos valores e atualiza para a próxima instrução.
\item O módulo \textbf{MEM/WB} armazena o resultado da operação no módulo \textbf{ID}.
\end{itemize}

\usecase{Instrução NOT}

Este caso de uso especifica a ação da instrução NOT. O objetivo é realizar a operação lógica NOT sobre um valor.
 
\subsubsection*{Atores}
\textbf{IF, ID, EX, MEM/WB}

\preconditions 
\begin{itemize}
 \item O módulo \textbf{IF} precisa buscar uma instrução NOT.
\end{itemize}

\postconditions
\begin{itemize}	
  \item Permitir execução de futuras instruções.
\end{itemize}

\subsubsection*{Fluxo Básico}
\begin{itemize}
\item O módulo \textbf{IF} busca a instrução NOT a ser executada.
\item O módulo \textbf{ID} decodifica o tipo da instrução, emite sinais de controle para os demais módulos e disponibiliza o valor para o módulo \textbf{EX}.
\item O módulo \textbf{EX} realiza a operação lógica determinada de negação do valor e atualiza para a próxima instrução.
\item O módulo \textbf{MEM/WB} armazena o resultado da operação no módulo \textbf{ID}.
\end{itemize}

\usecase{Instrução ANDI}

Este caso de uso especifica a ação da instrução ANDI. O objetivo é realizar uma a operação lógica AND entre dois valores sendo um destes imediato.

\subsubsection*{Atores}
\textbf{IF, ID, EX, MEM/WB}

\preconditions 
\begin{itemize}
	\item O módulo \textbf{IF} precisa buscar uma instrução ANDI.
\end{itemize}

\postconditions
\begin{itemize}	
	\item Permitir execução da próxima instrução.
\end{itemize}

\subsubsection*{Fluxo Básico}
\begin{itemize}
	\item O módulo \textbf{IF} busca a instrução ANDI a ser executada.
	\item O módulo \textbf{ID} decodifica o tipo da instrução, emite sinais de controle para os demais módulos e disponibiliza os valores para o módulo \textbf{EX}.
	\item O módulo \textbf{EX} realiza a operação lógica determinada dos valores e atualiza para a próxima instrução.
	\item O módulo \textbf{MEM/WB} armazena o resultado da operação no módulo \textbf{ID}.
\end{itemize}

\usecase{Instrução ORI}

Este caso de uso especifica a ação da instrução ORI. O objetivo é realizar a operação lógica OR entre dois valores sendo um destes imediato.

\subsubsection*{Atores}
\textbf{IF, ID, EX, MEM/WB}

\preconditions 
\begin{itemize}
	\item O módulo \textbf{IF} precisa buscar uma instrução ORI.
\end{itemize}

\postconditions
\begin{itemize}	
	\item Permitir execução da próxima instrução.
\end{itemize}

\subsubsection*{Fluxo Básico}
\begin{itemize}
	\item O módulo \textbf{IF} busca a instrução ORI a ser executada.
	\item O módulo \textbf{ID} decodifica o tipo da instrução, emite sinais de controle para os demais módulos e disponibiliza os valores para o módulo \textbf{EX}.
	\item O módulo \textbf{EX} realiza a operação lógica determinada dos valores e atualiza para a próxima instrução.
	\item O módulo \textbf{MEM/WB} armazena o resultado da operação no módulo \textbf{ID}.
\end{itemize}

\usecase{Instrução CMP}

Este caso de uso especifica a ação da instrução CMP. O objetivo é realizar a comparação entre dois valores.

\subsubsection*{Atores}
\textbf{IF, ID, EX}
\preconditions 
\begin{itemize}
	\item O módulo \textbf{IF} precisa buscar uma instrução CMP.
\end{itemize}

\postconditions
\begin{itemize}	
	\item Permitir execução da próxima instrução.
\end{itemize}

\subsubsection*{Fluxo Básico}
\begin{itemize}
	\item O módulo \textbf{IF} busca a instrução CMP a ser executada.
	\item O módulo \textbf{ID} decodifica o tipo da instrução, emite sinais de controle para os demais módulos e disponibiliza os valores para o módulo \textbf{EX}.
	\item O módulo \textbf{EX} realiza a comparação dos valores, atualiza o registrador de ocorrências e atualiza para a próxima instrução.
\end{itemize}

Basicamente, as instruções Lógicas e Aritméticas seguem um mesmo fluxo de execução:

\begin{figure}[H]
	\subsubsection*{Diagrama de Caso de Uso}
		\input{./usecases/instructionFetch.tikz}
\end{figure}
