tec499-20142/t01-core-musa/doc/architecture/step1.tex

\section{Leitura da Instrução}
	\subsection{Diagrama de Classe}
  \begin{figure}[h!]
    \input{./classes/step1.tikz}
  \end{figure}
		
		\subsection{Definições de entrada e saída}
		
	\begin{center}
		\begin{longtable}[pos]{| l | c | c | m{7cm} |} \hline
			\multicolumn{1}{|c|}{\cellcolor[gray]{0.9}\textbf{Nome}} & 
			\multicolumn{1}{c|}{\cellcolor[gray]{0.9}\textbf{Tamanho}} & 
			\multicolumn{1}{c|}{\cellcolor[gray]{0.9}\textbf{Direção}} &
			\multicolumn{1}{c|}{\cellcolor[gray]{0.9}\textbf{Descrição}} \\ \hline
			\endhead
			\hline
			\endlastfoot
			clock & 1 & entrada & Clock do sistema \\ \hline
			reset & 1 & entrada & Sinal de reinício do estágio\\ \hline
			pcInput & 32 & entrada & Endereço da instrução a ser buscada \\ \hline
			pcWrite & 1 & entrada & Sinal que habilita a modificação do valor de PC \\ \hline
			push & 1 & entrada & Sinal que habilita a escrita na Pilha de Instruções\\ \hline
			pop & 1 & entrada & Sinal que habilita a leitura da Pilha de Instruções\\ \hline
			pcStack & 32 & saida & Valor do PC armazenado no topo da Pilha de Instruções\\ \hline
			pcOutput & 32 & saída & Endereço da instrução que está sendo executada \\ \hline
			PC+1 & 32 & saída & Próximo endereço de PC \\ \hline
			instruction & 32 & saída & Instrução encontrada \\ \hline
			
		\end{longtable}
	\end{center}
	
	%\newpage
	
	\subsection{Datapath Interno}
	\begin{figure}[h!]
		\begin{center}
		
		\end{center}
	\end{figure}
