tec499-20142/t01-core-musa/doc/architecture/step4.tex

\section{Acesso à memória e write back}
	\subsection{Diagrama de Classe}
  \begin{figure}[H]
    \input{./classes/step4.tikz}
  \end{figure}

\subsection{Definições de entrada e saída}

	\begin{center}
        \begin{longtable}[pos]{| l | c | c | m{7cm} |} \hline
          \multicolumn{1}{|c|}{\cellcolor[gray]{0.9}\textbf{Nome}} & 
          \multicolumn{1}{c|}{\cellcolor[gray]{0.9}\textbf{Tamanho}} & 
          \multicolumn{1}{c|}{\cellcolor[gray]{0.9}\textbf{Direção}} &
          \multicolumn{1}{c|}{\cellcolor[gray]{0.9}\textbf{Descrição}} \\ \hline
          \endhead
          \hline
          \endlastfoot

          address & 32 & entrada & Endereço da memória de dados no qual o dado deve ser escrito   \\ \hline
          memRead                  & 1   & entrada   & Sinal proveniente da UC que habilita leitura    \\ \hline
          memWrite                 & 1   & entrada   & Sinal proveniente da UC que habilita escrita    \\ \hline
	      memToReg                 & 1   & entrada  & Sinal proveniente da UC que verifica qual dado será escrito no banco de registradores  \\ \hline
          data\_in      		   & 32   & entrada   & Dado a ser escrito na memória. \\ \hline
          writeBack	 & 32  & saída  & Dado que será escrito no banco de registradores \\ \hline
        \end{longtable}
      \end{center}
    
    \newpage  
\subsection{Datapath Interno}
	
	\begin{figure}[ht]
		\begin{center}
		
		%\caption*{Datapath dos estágios 4 e 5.}
		\end{center}
	\end{figure}
