tec499-20142/t01-core-musa/doc/usecases/compinstructions.tex

\usecase{Somar dois valores}
\usecase{Subtrair dois valores}
\usecase{Multiplicar dois valores}
\usecase{Dividir dois valores}
\usecase{Realizar um AND lógico}
\usecase{Realizar um OR lógico}
