tec499-20142/t01-core-musa/doc/usecases/usecases/instructionFetch.tikz.tex

\flushleft
  \begin{tikzpicture} 
    \begin{umlsystem}[x=0, fill=red!10]{Buscar Instrução} 
      \umlusecase[x=-4,y=-3,name=buscar]{Buscar} 
      \umlusecase[x=0,y=-3, fill=green!20,width=1cm, name=enviar]{Enviar} 

      \umlactor[x=-8,y=-3]{Instruction Fetch} 
      \umlactor[x=4,y=-3]{Instruction Decode}   

      \umlassoc{Instruction Fetch}{buscar}
      \umlassoc{enviar}{Instruction Decode}
      \umlassoc{buscar}{enviar}
    \end{umlsystem} 
  \end{tikzpicture}
