tec499-20142/t01-core-musa/doc/architecture/class_diagrams/Step_4.jpeg

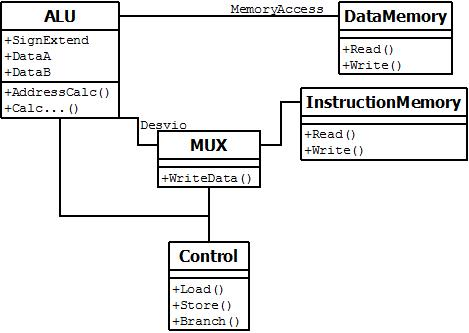
doc/architecture/class_diagrams/Step_4.jpeg
