tec499-20142/t01-core-musa/doc/architecture/datapath/step2.png

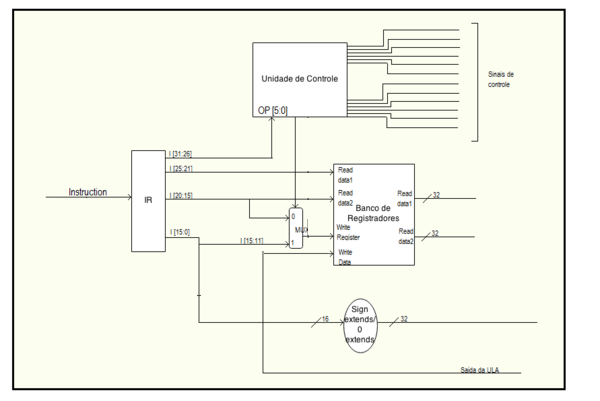
doc/architecture/datapath/step2.png
