tec499-20142/t01-core-musa/doc/architecture/datapath/Step4_datapath.png

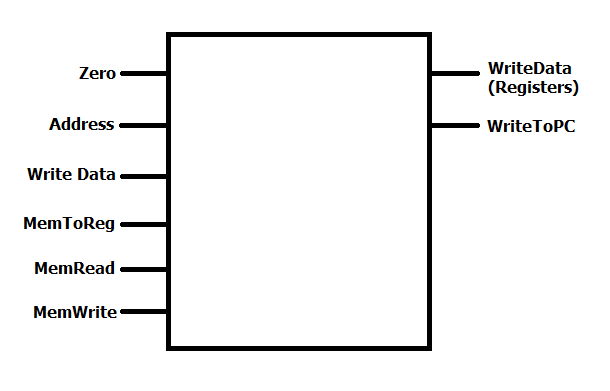
doc/architecture/datapath/Step4_datapath.png
