tec499-20142/t01-core-musa/doc/architecture/datapath/Step4_e_Step5.png

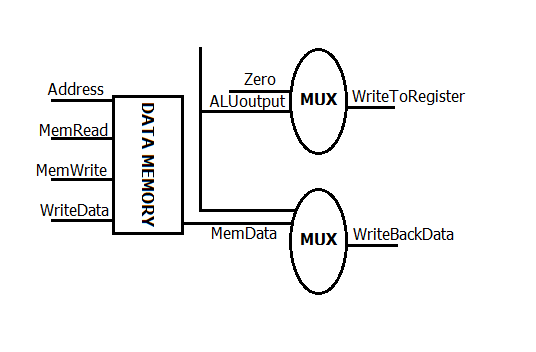
doc/architecture/datapath/Step4_e_Step5.png
