tec499-20142/t01-core-musa/sim/model/test.txt

012a8820
01498822
012a0018
00000000
012a001a
00000000
15200001
012a9024
012a9025
01404827
2129000a
3c010098
34219680
01615822
3131000c
3531000c
3c011001
ac290000
71205021
112a0003
0c100021
08100023
03e00008
08100000
