tec499-20142/t01-core-musa/sim/tb/'a.b'_memória_intrução_test_halt-cmp-etc.txt

00010000001000010000000000000111
00000000000000000000000000000000
00001000000000000000000000000010
00000000000000000000000000000000
00000000000000000000000000000000
00100000001000100000000000000011
01110000001000100010000000000010
00100000001000110000000000000000
01110100001000110000000000000000
00100000010000100000000000000010
00010000010000100000000000000001
00000000000000000000000000000000
00000000000000000000000000000000
11111100000000000000000000001101
