tec499-20142/t01-core-musa/rtl/IF/Stack.v

// +UEFSHDR----------------------------------------------------------------------
// 2014 UEFS Universidade Estadual de Feira de Santana
// TEC499-Sistemas Digitais
// ------------------------------------------------------------------------------
// TEAM: <P01>
// ------------------------------------------------------------------------------
// PROJECT: <MUSA>
// ------------------------------------------------------------------------------
// FILE NAME  : {Stack.v}
// KEYWORDS 	: {PC, Stack, UC}
// -----------------------------------------------------------------------------
// PURPOSE: {TBD}
// -----------------------------------------------------------------------------
// REUSE ISSUES
//   Reset Strategy      : <sychronous, active in low level reset>
//   Clock Domains       : <TBD>
//   Instantiations      : <None>
//   Synthesizable (y/n) : <y>
// -UEFSHDR----------------------------------------------------------------------

module Stack(clock, reset, readStack, writeStack, pc, stackOut, stackOverflow);

input clock;
input reset;
input readStack;
input writeStack;
input [31:0] pc;
output reg [31:0] stackOut;
reg [3:0] stackLevel = 4'b0000;
reg [31:0] regStack [0:7];
output reg stackOverflow;

always @(posedge clock)
begin

  if (~reset) begin
    stackLevel <= 4'b0;
    stackOverflow <= 1'b0;
  end
  else if (readStack == 1) begin 
      case (stackLevel)
        4'b0 : stackOverflow = 1'b1;
    			 4'b1 : begin stackLevel <= stackLevel - 1'd1;
  			               stackOut <= regStack [1'd0]; 
			         end
    			 4'b10 : begin stackLevel <= stackLevel - 1'd1;
  			               stackOut <= regStack [1'd1]; 
			         end
    			 4'b11 : begin stackLevel <= stackLevel - 1'd1;
  			               stackOut <= regStack [1'd2]; 
			         end
    			 4'b100 : begin stackLevel <= stackLevel - 1'd1;
  			               stackOut <= regStack [1'd3];
			         end
    			 4'b101 : begin stackLevel <= stackLevel - 1'd1;
  			               stackOut <= regStack [1'd4]; 
			         end
    			 4'b110 : begin stackLevel <= stackLevel - 1'd1;
  			               stackOut <= regStack [1'd5]; 
			         end
    			 4'b111 : begin stackLevel <= stackLevel - 1'd1;
  			               stackOut <= regStack [1'd6]; 
			         end
    			 4'b1000 : begin stackLevel <= stackLevel - 1'd1;
			               stackOut <= regStack [1'd7];
			         end
			endcase
  end
  if (writeStack == 1) begin  
      case (stackLevel)
    			 4'b0 : begin regStack [stackLevel] <= pc;
    			              stackLevel <= stackLevel + 1'd1;
			         end
    			 4'b1 : begin regStack [stackLevel] <= pc;
    			              stackLevel <= stackLevel + 1'd1;
			         end
    			 4'b10 : begin regStack [stackLevel] <= pc;
    			              stackLevel <= stackLevel + 1'd1;
			         end
    			 4'b11 : begin regStack [stackLevel] <= pc;
    			              stackLevel <= stackLevel + 1'd1;
			         end
    			 4'b100 : begin regStack [stackLevel] <= pc;
    			              stackLevel <= stackLevel + 1'd1;
			         end
    			 4'b101 : begin regStack [stackLevel] <= pc;
    			              stackLevel <= stackLevel + 1'd1;
			         end
    			 4'b110 : begin regStack [stackLevel] <= pc;
    			              stackLevel <= stackLevel + 1'd1;
			         end
    			 4'b111 : begin regStack [stackLevel] <= pc; 
    			              stackLevel <= stackLevel + 1'd1; 
			         end
    			 4'b1000 : stackOverflow <= 1'b1;
			endcase
  end
  
end
endmodule
