tec499-20142/t01-core-musa/rtl/ip/fpga-lcd-m8k-memory-read/rtl/lcd/Reset_Delay.v

module	Reset_Delay(iCLK,oRESET);
input		iCLK;
output reg	oRESET;
reg	[19:0]	Cont;

always@(posedge iCLK)
begin
	if(Cont!=20'hFFFFF)
	begin
		Cont	<=	Cont+1'b1;
		oRESET	<=	1'b0;
	end
	else
	oRESET	<=	1'b1;
end

endmodule
