tec499-20142/t01-core-musa/rtl/IF/InstructionMem.v

// +UEFSHDR----------------------------------------------------------------------
// 2014 UEFS Universidade Estadual de Feira de Santana
// TEC499-Sistemas Digitais
// ------------------------------------------------------------------------------
// TEAM: <P01>
// ------------------------------------------------------------------------------
// PROJECT: <MUSA>
// ------------------------------------------------------------------------------
// FILE NAME  : {InstructionMem.v}
// KEYWORDS 	: {Memory, Instruction, IF}
// -----------------------------------------------------------------------------
// PURPOSE: {TBD}
// -----------------------------------------------------------------------------
// REUSE ISSUES
//   Reset Strategy      : <None>
//   Clock Domains       : <TBD>
//   Instantiations      : <None>
//   Synthesizable (y/n) : <y>
// -UEFSHDR----------------------------------------------------------------------

module InstructionMem(address, data, clock);
  
input wire clock; 
input wire [31:0] address;
output reg [31:0] data; 
reg [2047:0] mem [31:0];  
initial begin
    $readmemb("a.b", mem);
end

  always @(posedge clock) begin
		data <= mem[address];
	end
endmodule
