tec499-20142/t01-core-musa/sim/ver/temp_ver/sign_extend/_primary.vhd

library verilog;
use verilog.vl_types.all;
entity sign_extend is
    port(
        inst            : in     vl_logic_vector(15 downto 0);
        inst_out        : out    vl_logic_vector(31 downto 0)
    );
end sign_extend;
