tec499-20142/t01-core-musa/sim/ver/temp_ver/sp_ram_with_init/_primary.vhd

library verilog;
use verilog.vl_types.all;
entity sp_ram_with_init is
    generic(
        DATA_WIDTH      : integer := 8;
        ADDR_WIDTH      : integer := 6
    );
    port(
        data            : in     vl_logic_vector;
        addr            : in     vl_logic_vector;
        we              : in     vl_logic;
        clk             : in     vl_logic;
        q               : out    vl_logic_vector
    );
    attribute mti_svvh_generic_type : integer;
    attribute mti_svvh_generic_type of DATA_WIDTH : constant is 1;
    attribute mti_svvh_generic_type of ADDR_WIDTH : constant is 1;
end sp_ram_with_init;
