tec499-20142/t01-core-musa/sim/tb/EX/alu_tb.v

module alu_tb(
output  [31:0] result, 
output  [2:0] flag);
 
 reg [31:0] data_a; 
 reg [31:0] data_b; 
 reg [2:0] alu_control; 
 reg [5:0] func; 
 reg [0:0]reset;
 
 initial begin
  reset = 0;
  reset = 1;
  data_a = 32'b10000000000000000000000000000000; 
  data_b = 32'b10000000000000000000000000000000; 
  alu_control = 0;
  func = 39;
  reset = 1;
  
 end  
 
  alu alu_tb(
	.reset(reset), 
	.data_a(data_a), 
	.data_b(data_b),
	.alu_control(alu_control),
	.func(func),  
	.result(result), 
	.flag(flag), 
	.branch(branch));
	
	
endmodule 
