tec499-20142/t01-core-musa/(commit log)

2014-09-26 Inicialização do documento com os requisitos de operações aritméticas retiradas do problema 01
2014-09-28 Adicionando requisitos das operações de desvio
2014-09-29 Add operações de NOT e CMP
2014-09-30 Requisitos de controle, Desenvolvido por: Anderson e Lucas
2014-09-30 Revisão do documento e adição de um requisito não funcional
2014-09-30 Revisão e adição de requisitos
2014-09-30 Revisão e adição de requisitos
2014-10-01 Requisito de desvio
    Pequena modificação no requisito de desvio JPC
2014-10-03 Up no doc de casos de uso
    Já separei em outros arquivos :) e deixei o do problema passado como
    base.
2014-10-06 Revisão das operações de desvio
2014-10-06 Modificando o número de compilação
2014-10-06 Refatoração
    Alterando a quantidade de bits dos dados e acrescentando as operação
    soma e subtração imediata
2014-10-06 Refatoração
    Adicionando OR e AND imediatos e alterando de 8 para 16 bits
2014-10-06 Revisão e acrescimo de requisitos de memória
2014-10-07 Adição e Revisão de requisitos
    Adição dos requisitos de operações com imediato e flags
2014-10-07 Organização de arquivos
    Adição dos arquivos: dependencias.tex e naofuncional.tex e identação do
    main document (sim, tenho TOC =/ )
2014-10-07 Adição do caos de uso da ULA
2014-10-07 Tentativa do diagrama de caso de uso
    *não é um diagrama definitivo*
2014-10-08 Adicionado dependência dos requisitos da Processing Unit e requisito do uso do padrão zero-extend e sign-extend para conversão de palavras de 16 bits para 32.
2014-10-08 mudança dos requisitos [FR29], [FR30], de NFR para FR, revisão dos requisitos [FR28], [NFR3], [NFR4] e [NFR5]. patrickecomp e mirelarios
2014-10-08 um começo do novo diagrama. (para Lucas)
    eu virei a página por isso esses 3 arquivos. (sugestão do prof.)
2014-10-09 Atualização do arquivo de caso de uso
2014-10-09 Definir siglas dos casos de uso
2014-10-09 Revisão final do documento de requisitos
2014-10-09 Adição de algumas siglas na tabela de definção. Modificação do texto dos casos de uso da unidade e controle e ula
2014-10-09 Registro de atividade no documento de casos de uso
2014-10-09 Inclusão do banco de registradores
    Ainda não está no documento principal
2014-10-11 Adição do diagrama de classes do passo 4 do MIPS
2014-10-13 Diagrama do State 3 (Anderson e Lucas)
    Esboço para ser discutido.
2014-10-14 Upload do documento de requisitos
    -Separei os arquivos (como de costume)
    -Comecei a editar a codificação das instruções (terminar mais tarde)
    p.s: não compilei xD mais tarde quando fizer a codificação faço isso xD
2014-10-14 Revert "Upload do documento de requisitos"
    This reverts commit 6cb3572d6365611d4bf82d1bddcd8eba98ad545b.
2014-10-14 Revert "Revert "Upload do documento de requisitos""
    This reverts commit b75348960416ab4d98211c3b8b0a67fb338d9249.
2014-10-16 Ajustes das instruções de desvios e da capa do documento. Ajustes das dependências. santana22 e gabri14el
2014-10-16 Adição do passo 4 ao documento de arquitetura
2014-10-16 Parte da refatoração do documento de requisitos
    Falta a parte dos flags, revisar o texto na seção de requisitos
    funcionais...
2014-10-16 Parte da refatoração do documento de casos de uso
2014-10-16 Ajuste nos requisitos funcionais de instrução de memória e ajuste nos requisitos não funcionais [NFR4] e [NFR2]. patrickecomp
2014-10-16 adição de algumas descrições dos formatos de instrução
2014-10-16 Alterações no documento de requisitos: 1) Alteração da definição das instruções HALT e NOP. 2)Alteração dos textos de introdução das seções introdução e requisitos funcionais
2014-10-16 Atualização do histórico de revisões
2014-10-16 Diagrama de classe do estágio EX
2014-10-19 Classe do estágio 3
    Tenho umas dúvidas de quantidade de bits das entradas e saidas que quero
    discutir com vocês. Também quero aproveitar e discutir sobre os
    parâmetros dos métodos de como é feito para circuitos.
2014-10-20 Adição a tabela de descrição das instruções
2014-10-21 Muita coisa, leiam as descrições.
    -Retirada dos arquivos e trechos do problema 1.
    -Criação dos arquivos tikz e tex dos estágio que ainda não estavam
    criados. (copiei tudo do step1, por favor façãm as devidas alterações.)
    -Alteração nas imagens das instruções.
    - Adição da tabela de OPCODE.
2014-10-24 Edição do caso de uso unidade de controle. mirelarios e patrickecomp
2014-10-24 Alguns ajustes de sintaxe.
2014-10-27 Ambiente de verificacao.
2014-10-29 Unificação das subseções de acesso à memória com a de write back
2014-10-29 Adição do diagrama de classe do estagio 2, patrickecomp e mirelarios
2014-10-29 Descrição entradas e saídas de Instruction Decode
2014-10-29 Alteração no caso de uso do extensor de bits
2014-10-30 Adição tabela de microinstruções, patrickecomp e mirelarios
2014-10-30 Correções da tabela de entradas e saidas (estagio 2)
2014-10-30 Difinições de bits da seção de memória
2014-10-30 Inclusão de datapath dos estágios 4 e 5
2014-10-30 Descrição e diagrama de classes do estágio ex
2014-11-09 RTL da memória e do banco de registradores. patrickecomp
2014-11-10 PDF do plano de verificação
2014-11-10 Atualização do estágio 3 no documento de arquitetura
2014-11-10 Correção das flags. Anderson e Lucas
    Ainda coloquei o pc_in que tava faltando no MUX com o data_a.
2014-11-10 Documento de Arquitetura sem a IMG do Datapath Interno. santana22
2014-11-17 Modificações na alu. Adicionado o parametro para a subtração imediata. Modificado a entrada que será utilizada para a operação not. Adicionado as saídas de overflow e underflow.
2014-11-17 Adicionado o tratamento de overflow na alu (Tarles e Lucas)
2014-11-17 Adicionado módulo de extensão de sinal
2014-11-17 Anderson
    Ai tem uma tabela de como é o opcode e a descrição em assembly de cada instrução e como elas serão utilizadas.
2014-11-17 Unidade de controle. patrickecomp, mirelarios, gabr14el
2014-11-17 Opcode das Instruções
    Neste documento está descrito como será implementado as instruções que não contém no MARS e os Opcode de todas instruções que serão utilizadas.
2014-11-17 TB utilizando Assertion
    Código de teste de leitura e escrita na memoria utilizando a metódologia
    FIFO. No código também está presente como é feito o Assertion.
2014-11-18 Adição de blocos e multiplexadores no stagio 2. patrickecomp
2014-11-18 correção de um errinho '-'
2014-11-19 Correção no banco de registradores, patrickecomp
2014-11-19 Acréscimo do fio de Jump para o estagio EX. patrickecomp, mirelarios e gabr14el
2014-11-20 Use case - Add
2014-11-20 Correções do opcode e adição das functions
    Correção de alguns opcodes e a retirada do JP que estava errado no documento. Segui como base o documento que do professor.
2014-11-20 Adicionado mux padrão de duas entradas com valor de seletor de um bit. Para utilizar MUX com mais de duas entradas basta apenas usar dois ou mais multiplexadores.
2014-11-20 Ambiente de verificação
    Início da montagem do ambiente
2014-11-20 Regras de projeto do ambiente de verificação
2014-11-20 Lógica das instruções
    Está ai todas as instruções que serão usadas e as entradas declaradas. Até a data de entrega esse código irá sofrer mudanças para garantir 100% do exigido. Portanto, esse será o guia.
2014-11-20 Alterações da ULA para adaptação do calculo de overflow e underflow. Alterações para os casos de opcodes e functions das instruções do tipo R.
2014-11-21 Atualização dos opcodes do doc de arq e do model
    Ainda falta coisas no modelo de referência
2014-11-22 Atualizado os Estimulos
    Pessoal, quero dividir esse código com vcs e quero fazer uma pergunta se este código de estimulo está de acordo com o requisitado. Tive como base o que Angelo me falou, "Não é preciso testar se o ta somando corretamente pra vários valores, ele foi projetado pra isso, acredite nele." Já já lanço o binário dele quando tudo estiver confirmado.
2014-11-23 Binário do código do MARS
    Esse ai é o binário daquele código que tinha enviado recentemente. Nele inclui os opcode modificados.
2014-11-23 Estagio 2 completo. Tudo pronto do estagio 2. Alterações agora só em caso de detectado algum erro. patrickecomp, mirelarios, gabr14el.
2014-11-23 modelo de referencia atualizado
2014-11-23 Já definido alguns aluOp nos parametros. Refeito a primeira parte da verificação do aluOp para instruções lógicas e aritméticas do tipo R
2014-11-24 Modificado todos os parametros para os valores de aluOp e function definidos. Realização das operações aritméticas e lógicas e as operações imediatas.
2014-11-24 Documento de Arquitetura com o datapath externo. santana22
2014-11-24 Verificação do overflow gerado nas operações aritméticas. Eu coloquei em um always separado, mas eu estou receioso, pois eu acho que não vai funcionar adequadamente.
2014-11-24 Adição do modulo estagio 4 e correção de detalhes no estagio 2
2014-11-24 Stage IF module. santana22
2014-11-24 Revert "um teste"
    This reverts commit 745e4361e6ef5c73462abde97e7841743eefe74d.
    [opcodes.v]
2014-11-24 Modificação do tamanho das entradas de controle e jump noestágio ex. Retirado dois always para tratamento de overflow e underflow.
2014-11-24 mudança de lugar
2014-11-24 Atualização do Plano de Teste. Manuelle e Anderson
2014-11-24 Modificado as entradas do estágio EX. Inserido um multiplexado para selecionar a entrada de data_b ou o valor do imeditado extendido. Organizando o método calc_next_address [entradas e código interno]
2014-11-24 Atualização do plano de verificação
2014-11-27 TESTEBENCH INICIAL DA UNIDADE DE CONTROLE
    testbench básico da unidade de controle, Gabriel, Patrick e Mirela.
    Arrumar maneira de testar os estágios.
2014-11-27 sign_extend testbench
    testbench básico para o modulo sig_extend gabriel, mirela e patrick
2014-11-27 Correção de erros na UC
2014-11-27 Teste da unidade de controle. patrickecomp, mirelarios e gabr14el
2014-12-07 Atualizando o documento de Arquitetura para o Instruction Fetch. santana22
2014-12-07 teste de propagaçao do pc. Verifico se durante os 5 estagios o sinal é propagado de maneira correta e a quantidade de pulsos por instrução tambem é correta. Para isso, foi necessario implementar esta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
2014-12-08 Teste de Leitura
    Manu, tem como tu rodar isso ai pra ve se ele ta pegando os valores
    corretos? Com isso funcionando vou poder jogar o código de teste de
    operações aritméticas.
2014-12-08 Teste 2 leitura
    Esqueci de selecionar esse. Mandei 2 formas de leitura. Roda ai e vê
    qual melhor.
2014-12-08 Alterações no modelo de referência!
    Ainda falta coisa.
2014-12-08 Corrigindo alguns erros da alu. Alterado o modulo de calculo do próximo endereço
    [alu.v, ex.v]
2014-12-08 Alteração do estágio EX para as novas adaptações dos valores de controle
2014-12-08 Modificado a entrada de seleção para a informação de data_a e data_b, que agora são 2 bits. Modificado o multiplexador para as entradas da alu.
2014-12-09 mudanças dos sinais de pc-select-a e pc-select-b, patrickecomp, mirelarios, gab14el
2014-12-09 Adicionado mais uma saída da alu, para informar se a comparação da constante enviada na instrução BRFL e o valor do registrador de flag são iguais. Um novo multiplexador é utilizado no estágio ex par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
2014-12-10 Termino das atualizações de sinais da unidade de controle. gab14el, patrickecomp, LucasAlmeida
2014-12-10 Alterado o arquivo de teste para verificar a operação de divisão. Alterações na ULA: retirado registrador redudante na ULA; retirada a atribuição do resultado do calculo dos casos para o final do mod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
2014-12-10 shift + correção de diretório
    hehe
2014-12-11 Correções na tabela de microinstruções
2014-12-11 Atualizando documento de Arquitetura. santana22
2014-12-11 Criação de controle do pop e push com sinal auxiliar
2014-12-11 Criação de um nop caso o opcode não exista
2014-12-11 Modificação da ULA para setar a flag de overflow e undeflow a depender dos casos do tipo R. Modificação do CMP para um valor de aluOp, além de mudar o caso na ALU.
2014-12-11 ambiente compilando (ainda não funcionando) :satisfied:
    Falta: editar os sinais de controle e algumas pequenas coisas.
    [verilog.psm]
2014-12-11 Atualização da atribuição de flags na ALU. Atualização do valor do CMP e o caso específico para tratamento da instrução
2014-12-11 Retirado o parametro CMP no local de functions
2014-12-11 Correção de erros na pilha e no dataPath.
2014-12-11 Adicionada a verificação do caso de exceção (divisão por zero)
2014-12-11 Acrescimo de teste de memória.
2014-12-11 Corrigido parametro redundante CMP. Alterado o teste
    [alu.v, alu_tb.v]
2014-12-11 Atualização no dapath do IF e historico de revisões
2014-12-11 Simulação do Clock
    Tentei nessa simulação ler o arquivo e buscar a instrução para ser
    executada em 5 ciclos de clock.
    [verilog.psm]
2014-12-11 Alterações na tabela de microinstruções [CMP, DIV]
    [MUL]
2014-12-11 Atualizando o documento de arquitetura
2014-12-11 Em processo de Atualização
2014-12-11 Teste de Integração. patrickecomp, lucasAlmeida, gabr14el
2014-12-12 Modificação do tamanho do fios no estágio EX que estava causando alta-impedância. Testebench do estágio ex
2014-12-12 Correção do mux no estagio ex. Erro de lógica. Correção do sinal aluOp.
2014-12-13 Resolvido problema de conflito entre duas instruções simultaneas.
    [ProgramCounter.v, Stack.v, StageTwo.v, dataPath.v, data_path_tb.v, stage_Four_Five.v, unit_control.v]
2014-12-13 Funcionamento de CALL e RET. Correção de erro de logica na pilha.
2014-12-14 Atualização do Modelo de Referencia
    Mudei algumas instruções que estavam erradas e coloquei o tamanho da
    memória.
2014-12-14 Documento de Arquitetura (sem datapaths internos)
2014-12-14 Estímulos Binário Simplificado
    Utilizem este arquivo como primeiro teste de funcionamento do processador.
2014-12-14 Alteração da ULA. Alteração do estágio ex - retirada a entrada de jump_address e no calc_next_address modificação dos parametros e seleção do próximo pc. O StageTwo modificado a quantidade de bits re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
2014-12-14 Modificação do operador not utilizado para a operação not
2014-12-14 Retirado valor de jump_address do estágio 2 (ID) . (Lucas e Patrick)
2014-12-14 Módulo de testes para o FPGA.
2014-12-15 Um ambiente de verificação...
    [verilog.psm]
2014-12-15 Refatorando Casos de Uso
2014-12-15 Alterações de sinais do pcSrc na unidade de controle e acrescimo do sinal de saida da divisão por 4
2014-12-15 Memória de intrução para testar instruções HALT, CMP, ADDI, NOP, BRFL e MUL
    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
2014-12-15 atualização do ambiente
    [verilog.psm]
2014-12-15 Modificado a saída de branch da alu
2014-12-15 Correção no array de registradores da pilha e acrescimo de saidas dos 4 bits menos significativos do endereço 1 do banco de registradores
2014-12-15 Estímulos Binários simplificado
    Utilizem esse arquivo como primero teste de fucionamento.
2014-12-15 Revert "Atualização do Modelo de Referencia"
    This reverts commit 73b979610d088d5f36a1906f4323834a39f3c46e.
    [mainBin.c]
2014-12-15 Revert "Revert "Atualização do Modelo de Referencia""
    This reverts commit 351cbe646f6d9a2f8a2a1805f24498aaa6f749de.
    [mainBin.c]
2014-12-15 Atualização do Modelo de Referência
    Anderson, Manuelle
2014-12-15 Datapath stage2 e stage3
2014-12-15 Teste de Modelo de Referencia executando
    Anderson e Manuelle. Testando a execução do Modelo de referência e
    visualizando as entradas e saídas em C.
2014-12-16 Modificação do indice de acesso ao banco de registradores. Acrescentado os valores do 4 bits menos significativo no testbench do data_path
2014-12-16 Tirando os lixos da pasta ver
    [verilog.psm]
2014-12-17 Modelo de Referência Atualiado e Funcionando
    Mudei o formato de bináro para hexa. Não conseguir ler o binário do
    arquivo. Perdi muito tempo tentando fazer isso e então testei com hexa e
    funcionou.
2014-12-17 conserto,
    pfvr alguém compila no quartus e me avisa se tiver algum erro, no model
    sim compilou de boa
2014-12-18 Alterações na ULA (tratamento de overflow e underflow), modificação do valor do branch para um no brfl se tomado. Unidade de controle - adicionado sinais de controle da instrução cmp, mudado o valor 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
2014-12-18 Alteração nos datapaths internos de todos estágios
2014-12-18 Resolução do problema CPI da instrução LW ser igual a 6
    [InstructionMem.v, dataPath.v, unit_control.v]
2014-12-18 refatorção casos de uso
2014-12-18 Resolução do problema de conflitos entre dados.
    [StageTwo.v, unit_control.v]
2014-12-18 refatoração casos de uso
2014-12-18 refatoração dos casos de uso
2014-12-18 Documento de Arquitetura (80% Finalizado)
2014-12-18 Adicionado fios para as saídas do lcd. Retidado atualização duplas de fio no datapath
2014-12-18 Documento de Arquitetura finalizado
2014-12-18 Documento de casos de uso
2014-12-18 Atualização do ambiente de verificação.
    [verilog.psm]
2014-12-18 Plano de verificação atualizado
2014-12-18 Atualização do ambiente de verificação
2014-12-18 Documento Casos de Uso finalizado. santana22 e tarleswalker
2014-12-18 arquivo necessário
    [verilog.psm]
2014-12-18 Modelo de referência por aqvale
2014-12-18 Modelo de Referência2 por aqvale
2014-12-19 Alterações com o BRFL funcionando.
    [verilog.psm]
2014-12-19 Adição dos binarios de teste das instruções
